ayuusweetfish/Yun-Ying-Ya/hw/Duck.kicad_pcb

## KiCad design hw/Duck.kicad_pcb (2024-12-11)

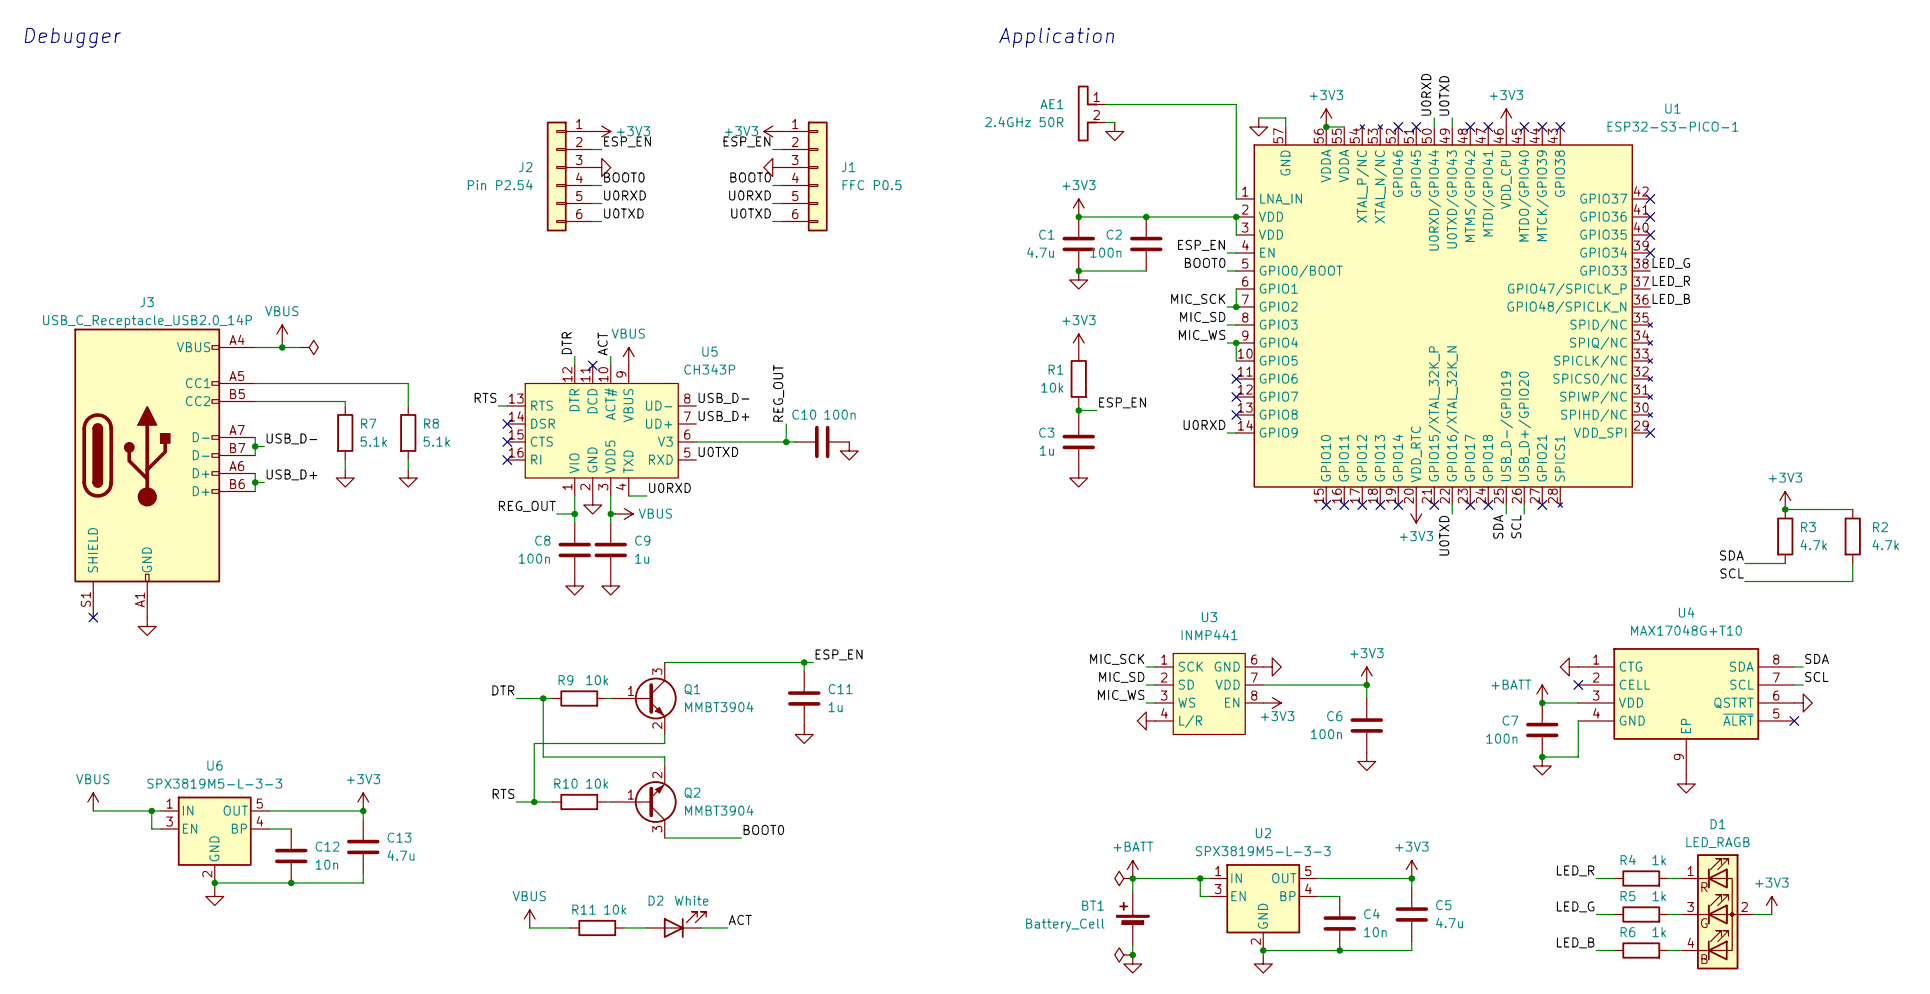
[picture p1: schematic Duck.kicad_sch]

Parts:
AE1: 2.4GHz 50R; ANT_IFA_USB_2.4GHz_50R
BT1: Battery_Cell; JST_GH_SM02B-GHS-TB_1x02-1MP_P1.25mm_Horizontal
C1, C5, C13: 4.7u; C_0402_1005Metric
C2, C6, C7, C8, C10: 100n; C_0402_1005Metric
C3, C9, C11: 1u; C_0402_1005Metric
C4, C12: 10n; C_0402_1005Metric
D1: LED_RAGB; LED_1x04_D5.0_P1.27
D2: White; LED_0603_1608Metric
J1: FFC P0.5; TestPoints_FFC_1x06_P0.5
J2: Pin P2.54; PinHeader_1x06_P2.54mm_Vertical
J3: USB_C_Receptacle_USB2.0_14P; USB_C_Receptacle
Q1, Q2: MMBT3904; SOT-23
R1, R9, R10, R11: 10k; R_0402_1005Metric
R2, R3: 4.7k; R_0402_1005Metric
R4, R5, R6: 1k; R_0402_1005Metric
R7, R8: 5.1k; R_0402_1005Metric
U1: ESP32-S3-PICO-1; ESP32-S3-PICO-1-LGA-56
U2, U6: SPX3819M5-L-3-3; SOT-23-5
U3: INMP441
U4: MAX17048G+T10; SON50P200X200X80-9N-D; Manufacturer_Part_Number MAX17048G+T10; Mouser Part Number 700-MAX17048G+T10
U5: CH343P; QFN-16-1EP_3x3mm_P0.5mm_EP1.9x1.9mm

Connections:
+3V3: C1.1, C2.1, C5.1, C6.1, C13.1, D1.2 (A), J1.1, J2.1, R1.1, R2.1, R3.1, U1.2 (VDD), U1.3 (VDD), U1.20 (VDD_RTC), U1.46 (VDD_CPU), U1.55 (VDDA), U1.56 (VDDA), U2.5 (OUT), U3.7 (VDD), U3.8 (EN), U6.5 (OUT)
+BATT: BT1.1 (+), C7.1, U2.1 (IN), U2.3 (EN), U4.3 (VDD)
/ACT: D2.1 (K), U5.10 (ACT#)
/BOOT0: J1.4, J2.4, Q2.3 (C), U1.5 (GPIO0/BOOT)
/DTR: Q2.2 (E), R9.1, U5.12 (DTR)
/ESP_EN: C3.1, C11.1, J1.2, J2.2, Q1.3 (C), R1.2, U1.4 (EN)
/LED_B: R6.1, U1.36 (GPIO48/SPICLK_N)
/LED_G: R5.1, U1.38 (GPIO33)
/LED_R: R4.1, U1.37 (GPIO47/SPICLK_P)
/MIC_SCK: U1.6 (GPIO1), U1.7 (GPIO2), U3.1 (SCK)
/MIC_SD: U1.8 (GPIO3), U3.2 (SD)
/MIC_WS: U1.9 (GPIO4), U1.10 (GPIO5), U3.3 (WS)
/REG_OUT: C8.1, C10.1, U5.1 (VIO), U5.6 (V3)
/RTS: Q1.2 (E), R10.1, U5.13 (RTS)
/SCL: R2.2, U1.26 (USB_D+/GPIO20), U4.7 (SCL)
/SDA: R3.2, U1.25 (USB_D-/GPIO19), U4.8 (SDA)
/U0RXD: J1.5, J2.5, U1.14 (GPIO9), U1.50 (U0RXD/GPIO44), U5.4 (TXD)
/U0TXD: J1.6, J2.6, U1.22 (GPIO16/XTAL_32K_N), U1.49 (U0TXD/GPIO43), U5.5 (RXD)
/USB_D+: J3.A6 (D+), J3.B6 (D+), U5.7 (UD+)
/USB_D-: J3.A7 (D-), J3.B7 (D-), U5.8 (UD-)
GND: AE1.2, BT1.2 (-), C1.2, C2.2, C3.2, C4.2, C5.2, C6.2, C7.2, C8.2, C9.2, C10.2, C11.2, C12.2, C13.2, J1.3, J2.3, J3.A1 (GND), J3.A12 (GND), J3.B1 (GND), J3.B12 (GND), R7.2, R8.2, U1.57 (GND), U2.2 (GND), U3.4 (L/R), U3.5 (GND), U3.6 (GND), U3.9 (GND), U4.1 (CTG), U4.4 (GND), U4.6 (QSTRT), U4.9 (EP), U5.2 (GND), U5.17 (GND), U6.2 (GND)
unnamed: D1.4 (BK), R6.2
unnamed: D1.3 (GK), R5.2
unnamed: D1.1 (RK), R4.2
unnamed: D2.2 (A), R11.2
unnamed: J3.A5 (CC1), R8.1
unnamed: J3.B5 (CC2), R7.1
unnamed: Q1.1 (B), R9.2
unnamed: Q2.1 (B), R10.2
unnamed: AE1.1, U1.1 (LNA_IN)
unnamed: C4.1, U2.4 (BP)
unnamed: C12.1, U6.4 (BP)
VBUS: C9.1, J3.A4 (VBUS), J3.A9 (VBUS), J3.B4 (VBUS), J3.B9 (VBUS), R11.1, U5.3 (VDD5), U5.9 (VBUS), U6.1 (IN), U6.3 (EN)

Notes on the sheet:
Debugger
Application

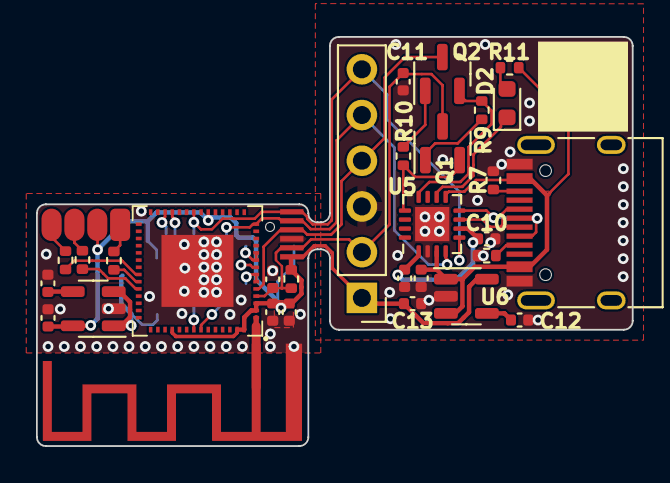
[picture p2: board Duck.kicad_pcb from above]

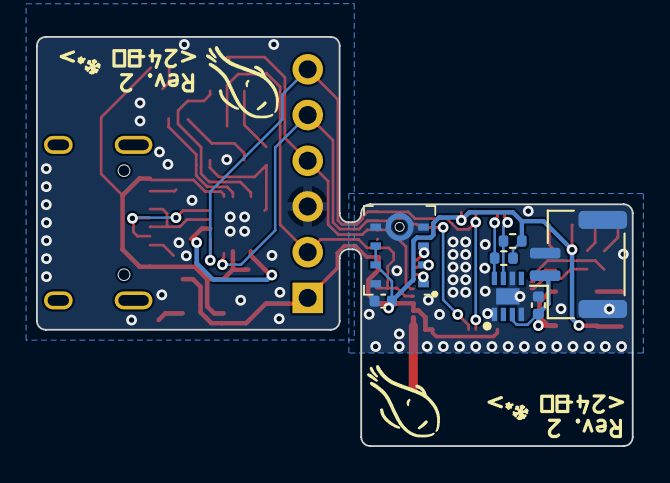
[picture p3: board Duck.kicad_pcb from below]

Board: 2 copper layers, 33.1 x 22.7 mm, 39 parts (7 on the bottom side), 33 nets.
