ayuusweetfish/Yun-Ying-Ya/fw/main/wifi_conn.c

#include "main.h"
#include "../../misc/net/net_tsinghua.h"

#include "esp_event.h"
#include "esp_log.h"
#include "esp_wifi.h"
#include "esp_timer.h"
#include "ping/ping_sock.h"
#include <string.h>

#if __has_include("wifi_cred.h")
  #include "wifi_cred.h"
  // EXAMPLE_ESP_WIFI_SSID, EXAMPLE_ESP_WIFI_PASS or
  // EXAMPLE_ESP_WIFI_SSID, EXAMPLE_ESP_WIFI_AUTH_USER, EXAMPLE_ESP_WIFI_AUTH_PASS
  // EXAMPLE_ESP_WIFI_SSID, EXAMPLE_ESP_WIFI_EAP_USER, EXAMPLE_ESP_WIFI_EAP_PASS
#endif

#if defined(EXAMPLE_ESP_WIFI_EAP_USER) && defined(EXAMPLE_ESP_WIFI_EAP_PASS)
  #define PEAP 1
  #ifndef EXAMPLE_ESP_WIFI_EAP_ANON
  #define EXAMPLE_ESP_WIFI_EAP_ANON "user@tsinghua.edu.cn"
  #endif
  #include "esp_eap_client.h"
  // Needs extra component `wpa_supplicant`
#else
  #define PEAP 0
#endif

#if defined(EXAMPLE_ESP_WIFI_AUTH_USER) && defined(EXAMPLE_ESP_WIFI_AUTH_PASS)
  #define HTTP_AUTH 1
#else
  #define HTTP_AUTH 0
#endif

#if !defined(EXAMPLE_ESP_WIFI_SSID) || (!defined(EXAMPLE_ESP_WIFI_PASS) && !PEAP && !HTTP_AUTH)
  #warning "Wi-Fi is currently no-op."
  #warning "To enable, define credentials in wifi_cred.h (refer to wifi_cred.example.h)"
  void wifi_init_sta(void) { }
  bool wifi_is_present() { return false; }

#else   // Actual implementation, to file end

bool wifi_is_present() { return true; }

#define EXAMPLE_ESP_MAXIMUM_RETRY  5

#define ESP_WIFI_SAE_MODE WPA3_SAE_PWE_BOTH
#define EXAMPLE_H2E_IDENTIFIER "PASSWORD IDENTIFIER"
#if PEAP
  #define ESP_WIFI_SCAN_AUTH_MODE_THRESHOLD WIFI_AUTH_WPA2_ENTERPRISE
#elif HTTP_AUTH
  #define ESP_WIFI_SCAN_AUTH_MODE_THRESHOLD WIFI_AUTH_OPEN
#else
  #define ESP_WIFI_SCAN_AUTH_MODE_THRESHOLD WIFI_AUTH_WPA2_PSK
#endif

/* FreeRTOS event group to signal when we are connected*/
static EventGroupHandle_t s_wifi_event_group;

/* The event group allows multiple bits for each event, but we only care about two events:
 * - we are connected to the AP with an IP
 * - we failed to connect after the maximum amount of retries */
#define WIFI_CONNECTED_BIT BIT0
#define WIFI_FAIL_BIT      BIT1

#define TAG "Wi-Fi STA"

static int s_retry_num = 0;


static void event_handler(void* arg, esp_event_base_t event_base,
                          int32_t event_id, void* event_data)
{
  if (event_base == WIFI_EVENT && event_id == WIFI_EVENT_STA_START) {
    esp_wifi_connect();
    ESP_LOGI(TAG, "starting");
  } else if (event_base == WIFI_EVENT && event_id == WIFI_EVENT_STA_DISCONNECTED) {
    if (s_retry_num < EXAMPLE_ESP_MAXIMUM_RETRY) {
      esp_wifi_connect();
      s_retry_num++;
      ESP_LOGI(TAG, "retry to connect to the AP");
    } else {
      xEventGroupSetBits(s_wifi_event_group, WIFI_FAIL_BIT);
    }
    ESP_LOGI(TAG, "disconnected from AP");
  } else if (event_base == IP_EVENT && event_id == IP_EVENT_STA_GOT_IP) {
    ip_event_got_ip_t* event = (ip_event_got_ip_t*) event_data;
    ESP_LOGI(TAG, "got ip:" IPSTR, IP2STR(&event->ip_info.ip));
    s_retry_num = 0;
    xEventGroupSetBits(s_wifi_event_group, WIFI_CONNECTED_BIT);
  }
}

extern uint8_t ca_pem_start[] asm("_binary_ca_pem_start");
extern uint8_t ca_pem_end[]   asm("_binary_ca_pem_end");

void wifi_init_sta(void)
{
  ESP_LOGI(TAG, "Connecting to Wi-Fi \"" EXAMPLE_ESP_WIFI_SSID "\" with authentication "
#if PEAP
    "PEAP"
#elif HTTP_AUTH
    "HTTP-based"
#else
    "WPA2"
#endif
  );

  s_wifi_event_group = xEventGroupCreate();

  ESP_ERROR_CHECK(esp_netif_init());

  ESP_ERROR_CHECK(esp_event_loop_create_default());
  esp_netif_create_default_wifi_sta();

  wifi_init_config_t cfg = WIFI_INIT_CONFIG_DEFAULT();
  ESP_ERROR_CHECK(esp_wifi_init(&cfg));

  esp_event_handler_instance_t instance_any_id;
  esp_event_handler_instance_t instance_got_ip;
  ESP_ERROR_CHECK(esp_event_handler_instance_register(WIFI_EVENT,
                                                      ESP_EVENT_ANY_ID,
                                                      &event_handler,
                                                      NULL,
                                                      &instance_any_id));
  ESP_ERROR_CHECK(esp_event_handler_instance_register(IP_EVENT,
                                                      IP_EVENT_STA_GOT_IP,
                                                      &event_handler,
                                                      NULL,
                                                      &instance_got_ip));

  esp_log_level_set("wifi", ESP_LOG_VERBOSE);
  esp_log_level_set("wpa", ESP_LOG_VERBOSE);
  esp_log_level_set("eap", ESP_LOG_VERBOSE);

  wifi_config_t wifi_config = {
    .sta = {
      .ssid = EXAMPLE_ESP_WIFI_SSID,
      /* Authmode threshold resets to WPA2 as default if password matches WPA2 standards (password len => 8).
       * If you want to connect the device to deprecated WEP/WPA networks, Please set the threshold value
       * to WIFI_AUTH_WEP/WIFI_AUTH_WPA_PSK and set the password with length and format matching to
       * WIFI_AUTH_WEP/WIFI_AUTH_WPA_PSK standards.
       */
      .threshold.authmode = ESP_WIFI_SCAN_AUTH_MODE_THRESHOLD,
    #if PEAP
    #elif HTTP_AUTH
      .password = "",
    #else
      .password = EXAMPLE_ESP_WIFI_PASS,
      // .sae_pwe_h2e = ESP_WIFI_SAE_MODE,
      // .sae_h2e_identifier = EXAMPLE_H2E_IDENTIFIER,
    #endif

      .listen_interval = 10,
    },
  };
  ESP_ERROR_CHECK(esp_wifi_set_mode(WIFI_MODE_STA) );
  ESP_ERROR_CHECK(esp_wifi_set_config(WIFI_IF_STA, &wifi_config) );

#if PEAP
  ESP_ERROR_CHECK(esp_eap_client_set_ca_cert(ca_pem_start, ca_pem_end - ca_pem_start));
  ESP_ERROR_CHECK(esp_eap_client_set_identity((uint8_t *)EXAMPLE_ESP_WIFI_EAP_ANON, strlen(EXAMPLE_ESP_WIFI_EAP_ANON)));
  ESP_ERROR_CHECK(esp_eap_client_set_username((uint8_t *)EXAMPLE_ESP_WIFI_EAP_USER, strlen(EXAMPLE_ESP_WIFI_EAP_USER)));
  ESP_ERROR_CHECK(esp_eap_client_set_password((uint8_t *)EXAMPLE_ESP_WIFI_EAP_PASS, strlen(EXAMPLE_ESP_WIFI_EAP_PASS)));
  ESP_ERROR_CHECK(esp_wifi_sta_enterprise_enable());
#endif

  ESP_ERROR_CHECK(esp_wifi_start());
  ESP_ERROR_CHECK(esp_wifi_set_ps(WIFI_PS_MAX_MODEM));

  ESP_LOGI(TAG, "wifi_init_sta finished.");

  /* Waiting until either the connection is established (WIFI_CONNECTED_BIT) or connection failed for the maximum
   * number of re-tries (WIFI_FAIL_BIT). The bits are set by event_handler() (see above) */
  EventBits_t bits = xEventGroupWaitBits(
    s_wifi_event_group,
    WIFI_CONNECTED_BIT | WIFI_FAIL_BIT,
    pdFALSE,
    pdFALSE,
    portMAX_DELAY);

  /* xEventGroupWaitBits() returns the bits before the call returned, hence we can test which event actually
   * happened. */
  if (bits & WIFI_CONNECTED_BIT) {
    ESP_LOGI(TAG, "connected to ap SSID:%s", EXAMPLE_ESP_WIFI_SSID);
  } else if (bits & WIFI_FAIL_BIT) {
    ESP_LOGI(TAG, "Failed to connect to SSID:%s", EXAMPLE_ESP_WIFI_SSID);
  } else {
    ESP_LOGE(TAG, "UNEXPECTED EVENT");
  }

  // Update time
  if (esp_reset_reason() == ESP_RST_POWERON) {
    ESP_LOGI(TAG, "Updating time from NVS");
    ESP_ERROR_CHECK(update_time_from_nvs());
  }

  const esp_timer_create_args_t nvs_update_timer_args = {
    .callback = (void *)&fetch_and_store_time_in_nvs,
  };

  esp_timer_handle_t nvs_update_timer;
  ESP_ERROR_CHECK(esp_timer_create(&nvs_update_timer_args, &nvs_update_timer));
  ESP_ERROR_CHECK(esp_timer_start_periodic(nvs_update_timer, 86400000000ULL));

  // Check connectivity by pinging an address
  esp_ping_config_t ping_cfg = ESP_PING_DEFAULT_CONFIG();
  ipaddr_aton("1.1.1.1", &ping_cfg.target_addr);
  ping_cfg.interval_ms = 100;
  ping_cfg.timeout_ms = 500;
  ping_cfg.count = 3;

  esp_ping_handle_t ping;
  // Stack-allocated (non-static) variables results in a crash during context switches
  static uint32_t n_reply, time_gap;
  static bool ended;
  void on_ping_success(esp_ping_handle_t ping, void *_unused) {
    n_reply++;
    uint32_t t;
    esp_ping_get_profile(ping, ESP_PING_PROF_TIMEGAP, &t, sizeof t);
    time_gap += t;
  }
  void on_ping_timeout(esp_ping_handle_t ping, void *_unused) { }
  void on_ping_end(esp_ping_handle_t ping, void *_unused) { ended = true; }
  ESP_ERROR_CHECK(esp_ping_new_session(&ping_cfg, &(esp_ping_callbacks_t){
    .on_ping_success = on_ping_success,
    .on_ping_timeout = on_ping_timeout,
    .on_ping_end = on_ping_end,
  }, &ping));

#if HTTP_AUTH   // Label unused otherwise
recheck:
#endif
  n_reply = time_gap = 0;
  ended = false;
  ESP_LOGI(TAG, "Starting ping session");
  ESP_ERROR_CHECK(esp_ping_start(ping));
  while (!ended && n_reply == 0) vTaskDelay(pdMS_TO_TICKS(1000));
  // Don't need to explicitly stop
  ESP_LOGI(TAG, "Ping result: received %"PRIu32", total time gap %"PRIu32" ms", n_reply, time_gap);

#if HTTP_AUTH
  // Only perform authentication when ping failed
  if (n_reply == 0) {
    ESP_LOGI(TAG, "Performing HTTP-based authentication");
    int result = net_tsinghua_perform_login(EXAMPLE_ESP_WIFI_AUTH_USER, EXAMPLE_ESP_WIFI_AUTH_PASS);
    ESP_LOGI(TAG, "Result: %d", result);
    goto recheck;
  }
#endif

  esp_ping_delete_session(ping);
}

#if HTTP_AUTH
const char *net_tsinghua_request(const char *url, const char *cookies)
{
  return simple_request(url, cookies);
}
#endif

#endif  // Actual implementation, from #else
