ayuusweetfish/Yun-Ying-Ya/fw/main/wifi_cred.example.h

#if 0

#define EXAMPLE_ESP_WIFI_SSID "Future Lab-6F"
#define EXAMPLE_ESP_WIFI_PASS "--"
#define TEST_SERVER_IP "192.168.1.100"

#elif 1

#define EXAMPLE_ESP_WIFI_SSID "Tsinghua-IPv4"
#define EXAMPLE_ESP_WIFI_AUTH_USER "user"
#define EXAMPLE_ESP_WIFI_AUTH_PASS "qwqwq"

#else

#define EXAMPLE_ESP_WIFI_SSID "Tsinghua-Secure"
#define EXAMPLE_ESP_WIFI_EAP_ANON "user"
#define EXAMPLE_ESP_WIFI_EAP_USER "user"
#define EXAMPLE_ESP_WIFI_EAP_PASS "qwqwq"

#endif
