ayuusweetfish/Yun-Ying-Ya/(commit log)

2024-11-10 🎉 Add check & visualisation tool
2024-11-18 server: Switch to 01.AI
2024-11-19 fw: 🚧 Enterprise Wi-Fi
2024-11-19 fw: 🚧 Enterprise Wi-Fi...??
2024-11-20 fw: 🚧 Enterprise Wi-Fi......????
    [partitions.csv]
2024-11-20 fw: Enable pull down on I2S data pin
2024-11-20 fw: 🚧 Enterprise Wi-Fi (probably skipping)
    Tsinghua-Secure uses TLS v1.0, the support for which is dropped in Mbed TLS v3.1.0 / ESP-IDF v5.0 (https://docs.espressif.com/projects/esp-idf/en/v5.0.7/esp32s3/migration-guides/release-5.x/protocols.html)
    [main.c, wifi_conn.c]
2024-11-21 Revert "fw: 🚧 Enterprise Wi-Fi (probably skipping)"
    This reverts commit 0745472ca29eb167ad7444771342a1c00f29d3e9.
    [main.c, wifi_conn.c]
2024-11-21 fw: Add ESP-SR
    [partitions.csv]
2024-11-21 fw: Correctly enable AFE with noise suppression
    Barring "Ringbuffer of AFE is full." warnings
    [audio.c]
2024-11-21 fw: Wake-up words 🎉
2024-11-21 fw: Switch to a TTS-trained model ("Hi, Miaomiao")
2024-11-24 misc: 🚧 Complete login request
2024-11-24 fw: Connect to open Wi-Fi with HTTP-based auth 🚧
2024-11-24 fw: Connected to Internet through Tsinghua SSID 🎉
2024-11-26 server: Switch test to chunked encoding
2024-11-26 fw: Streaming chunked request (untested 🚧)
2024-11-26 hw: Initial schematic and libraries
    [Duck.kicad_pcb, Duck.kicad_sch]
2024-11-26 hw: Finish schematic
    [Duck.kicad_sch]
2024-11-26 hw: Avoid IO26 due to module internal routing
    [Duck.kicad_sch]
2024-11-26 hw: Layout
    [Duck.kicad_pcb, Duck.kicad_sch]
2024-11-26 hw: Routing
    [Duck.kicad_pcb]
2024-11-26 hw: Minor revisions
    [Duck.kicad_pcb]
2024-11-27 hw: Finalize (...or is it?)
    [Duck.kicad_pcb]
2024-11-27 hw: Finalize; submit for fab (Rev. 1)
    [Duck.kicad_pcb, Duck.kicad_sch]
2024-11-27 hw: Adjust silkscreen text position (resubmit)
    [Duck.kicad_pcb]
2024-11-29 fw: Testing with onboard LED
    ESP32-S3-DevKitC-1 v1.0, LED = GPIO48
2024-12-02 fw: Move to the actual board 🎉
2024-12-02 fw: Pull microphone enable pin high
2024-12-03 fw: Add power management (no effect?)
2024-12-04 server: Refactor to incorporate different LLMs 🚧
2024-12-05 server: Complete pipeline from speech to commands 🎉
2024-12-06 fw: Switch to LEDC for PWM light output
2024-12-06 fw: Implement LED state transitions
2024-12-07 server: Fully implement response 🎉
2024-12-09 fw: Correctly enter modem- & light-sleep
    [led.c, main.c, request.c, wifi_conn.c]
2024-12-09 hw: Create ECAD models for ESP32-S3-PICO-1
2024-12-09 hw: 🚧 Revision
    [Duck.kicad_pcb, Duck.kicad_sch]
2024-12-09 hw: 🚧 Adjustments; layout?
    [Duck.kicad_pcb, Duck.kicad_sch]
2024-12-10 hw: 🚧 Do we give up this small form factor?
    [Duck.kicad_pcb, Duck.kicad_sch]
2024-12-10 fw: Keep LEDC PWM running during light sleep
2024-12-10 fw: Enable ULP 💡💤
2024-12-10 fw: 小鸭小鸭 🦆🎉
2024-12-10 hw: Further simplify 🚧
    [Duck.kicad_pcb, Duck.kicad_sch]
2024-12-10 hw: Complete revision
    [Duck.kicad_pcb, Duck.kicad_sch]
2024-12-10 hw: Most of the polish
    [Duck.kicad_pcb]
2024-12-10 hw: Hopefully all finished; polish in the details to-do
    [Duck.kicad_pcb]
2024-12-11 hw: Finalize PCB details
    [Duck.kicad_pcb]
2024-12-11 hw: Schematic page layout
    [Duck.kicad_pcb, Duck.kicad_sch]
2024-12-11 hw: Final stretch; submit for fab (Rev. 2)
    [Duck.kicad_pcb]
2024-12-11 hw: Revise schematic and update PCB; resubmit (Rev. 2)
    [Duck.kicad_pcb, Duck.kicad_sch]
2024-12-11 hw: Fix missing power line (/_<); resubmit (Rev. 2)
    [Duck.kicad_pcb, Duck.kicad_sch]
2024-12-14 fw: 🚧 Go to sleep and fix race conditions in LED update task
    [audio.c, led.c, main.c, main.h]
2024-12-14 fw: Try further reducing sleep interrupts
2024-12-14 fw: 🚧 Capture ULP wake-ups
2024-12-14 fw: Change to shared-memory flags to avoid wake-up signal misses
    [main.c]
2024-12-14 fw: Move to semaphores, finally 🎉💤
2024-12-15 fw: Set LED GPIO output strength
2024-12-15 fw: 🚧 Read back PWM in ULP?
2024-12-16 fw: 🚧 Test ULP speed limits
2024-12-16 fw: Confirmed ULP correctly clocked by XTAL/2 🎉
    [main.c]
2024-12-19 fw: Run on board Rev. 2
2024-12-20 fw: (Mostly) correctly output I2S clock signals from LEDC
    [led.c, main.c, pins.h]
2024-12-20 fw: 🚧 Read more bits in ULP?
2024-12-21 fw: Revert semaphores in LED routine
    ... which increases current consumption (6.05 mA -> 9.15 mA). Needs further investigation
    [led.c, main.c]
2024-12-22 fw: Resolve LED task suspension/power consumption issue
    [led.c]
2024-12-23 fw: Resolve I2S samples off by one bit
    [audio.c, led.c]
2024-12-23 fw: Work around bit timing issue after reset?
    [led.c]
2024-12-24 fw: Switch between ULP and I2S peripheral
2024-12-24 fw: Pump audio data to AFE again
2024-12-25 fw: 🎉 Full interaction loop with sleep!
2024-12-25 fw: Monitor background noise in ULP
    [main.c]
2024-12-25 fw: 🚧 Trying to resolve a race condition?
    [audio.c, main.c]
2024-12-25 fw: Resolve race condition in audio pause/resume
    [audio.c, main.c]
2024-12-25 server: 🚧 Resolving WebSocket closed-by-remote issue
2024-12-25 server, fw: Correctly handle remote early-close scenario; resolve truncated audio
    [main.c]
2024-12-25 fw: Upgrade dependencies
    Specifically, upgrade ESP-SR to 1.9.5 where 小鸭小鸭 model is bundled
2024-12-25 fw: Read battery fuel gauge MAX17048 🚧 (still NACK?)
2024-12-26 fw: Robust battery fuel gauge handling
    Barring a reset on disconnection
    [gauge.c, main.c, main.h]
2024-12-26 fw: Slightly optimise current consumption
2024-12-26 fw: 🚧 Feed external (non-I2S) data into audio input stream
2024-12-26 fw: 🚧 Refactor for merging external audio blocks
2024-12-26 fw: Switch to ESP-SR's VAD for more accurate speech activity detection
2024-12-29 fw: 🚧 Refactor for more manual data push (untested)
2024-12-30 fw: Fix previous refactor, working now
    [audio.c, main.c]
2024-12-30 fw: 🚧 Directly push ULP-captured samples?
2024-12-30 fw: 🚧 Dump ULP-captured waveform
2024-12-30 fw: Fix ULP captured data
    [main.c]
2024-12-30 fw: Bring back the main loop (🚧 Almost!)
    Only works the first time
2024-12-30 fw: Correctly running main loop 🎉
    [audio.c, main.c]
2024-12-30 fw: 🚧 Adjust thresholds?
2024-12-30 fw: Seemingly completed low-power audio acquisition?
2024-12-30 fw: 🚧 Who knows how this glitches??
    [main.c]
2024-12-31 fw: Further attempts to fix glitching audio
    [audio.c, led.c, main.c]
2024-12-31 fw: 🚧 Trying to synchronise the timers
2024-12-31 fw: 🚧 Attempt at more precise synchronisation?
2024-12-31 fw: 🚧 But anyway happy Gregorian new year from UTC+8!
2025-01-01 fw: 🚧 Remove unused registers into the assembly block
    ... but is this really possible with ULP-RISC-V?
2025-01-01 fw: 🚧 Still fixing?
    [main.c]
2025-01-01 fw: Revert to aligned edges??
    [led.c, main.c]
2025-01-02 fw: 🚧🌀
2025-01-02 fw: 🚧 Test ULP cycles
2025-01-02 fw: 🚧 Align to WS edges with RDCYCLE
2025-01-02 fw: 🚧 Correctly reading from testbed waveform
    [main.c]
2025-01-02 fw: 🚧 NOP sled
2025-01-02 fw: Correctly read without glitching, although only 6 bits
    [audio.c, led.c, main.c, pins.h]
2025-01-02 fw: 🚧 More sled
2025-01-02 fw: 🚧 Cycle-accurate compensated!
2025-01-02 fw: Correctly sampling 8~9 bits
    [main.c]
2025-01-02 fw: Correctly sample 9 bits
    [main.c]
2025-01-03 fw: 🎉 Finally, reading clean signals from ULP
2025-01-03 fw: 🎉 Minor optimisations. Low-power VAD works!
2025-01-03 fw: Resolve occasional missing audio blocks
    (By increasing maximum CPU frequency during processing)
    [audio.c, main.c]
2025-01-04 server: Switch to Lua implementation of sanity checks
2025-01-04 server, misc: Revise prompt and switch models (DeepSeek v3 & Gemini 2.0 Flash)
2025-01-08 fw: Further improve ULP audio monitoring
    (1) Fill samples' unread LSb's by sign-extending (rounding to zero)
    (2) Add hard-reset in thresholding
    [audio.c, main.c]
2025-01-08 fw: Fixed time interval for the main update loop
    [main.c]
2025-01-09 fw: 🚧 Opus encoding (WIP)
2025-01-09 fw: Fix erroneous buffer transmission
    [main.c]
2025-01-10 misc: 🚧 Opus decoding from WASM
2025-01-10 misc: WebAssembly Opus decoding 🎉
2025-01-13 fw: Fix incorrectly built libopus
    Previous versions linked with the code within `esp_audio_codec` component
    [audio.c]
2025-12-12 fw: Upgrade project to ESP-IDF v5.5.1 ❄
2025-12-15 fw: Resolve unused label warning
    [wifi_conn.c]
2025-12-15 fw: Resolve sample rate off by 0.16% issue
    [led.c, main.c]
2025-12-16 fw: Updates for testing
    1. Lower VAD threshold from 1000 to 600
    2. Correctly run application loop without Wi-Fi configuration (set to no-op)
    Known issue: encode task does not refresh watchdog?
    [audio.c, main.c, main.h, request.c, wifi_conn.c]
2025-12-17 fw: Adjust window sizes
    - ULP VAD: 64 -> 128 samples (4 -> 8 ms)
    - ESP-SR VAD trigger-clear threshold: 1 -> 1.5 s
    - Seems wake-up word detection triggers less reliably when this is too low (may trigger at next ULP VAD wake-up)
    [audio.c, main.c]
2025-12-19 fw: Fix incorrectly printed sled cycle count inspection values
    [main.c]
2025-12-23 fw: Reduce SPI flash size to 4 MiB
    ... for more board compatibility. In particular, this runs on -FH4R2 models
2025-12-23 fw: (WIP) Trying to understand the timers (again?)...
2025-12-26 fw: Format delay sled assembly
2025-12-27 fw: Fix encoder task taking up all CPU time
    Allows the idle task to run.
    Should ditch `vTaskSuspend()` and rely on semaphores. Should check whether this correctly triggers auto light-sleep.
    [encode.c]
2025-12-27 fw: Replace unreliable delay with semaphore signaling
    [encode.c]
2025-12-28 fw: Avoid WPA3 configuration for broader compatibility?
    [wifi_conn.c]
2025-12-28 server: Migrate from Google's Gemini to Qwen-Coder
    Because Google AI Studio radically cut the quota for the free tier (20 RPD).
    Also, fix a regexp overlook for exactly-suffix triple backticks.
2026-01-18 fw: Upgrade project to ESP-IDF v5.5.2 ❄
2026-01-18 fw: Add a demo animation
    “小鸭小鸭，你见过日落吗？”
